vladimir-aubrecht/BelimoCRAB1P/(commit log)

2023-03-04 Added scheme
    [BelimoCRAB1P.kicad_pcb, BelimoCRAB1P.kicad_sch]
2023-03-04 Added working support for reading of current state.
    [configuration.h]
2023-03-11 Added printables link.
2023-03-11 When connection fails during the startup, then access point is started and allows reconfiguration through web interface. After reconfiguration is done, device is automatically restarted.
    [configuration.h, configurationServer.h]
2023-03-11 Fixed bugs
    [configuration.h, configurationServer.h]
2023-09-02 - Web server is running all the time. - Added support for OTA updates of firmware. No need of cable anymore. - Logs are accessible through serial or through web server. - Passwords are rendered into 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
    [configurationServer.h]
2025-06-14 Improved logging and added retry for mqtt connection when mqtt connection drops
    [configurationServer.h]
2025-06-15 Initial hack
    [configurationServer.h]
2025-06-15 Refactored, but not tested yet
    [configuration.h]
2025-06-16 Working support for HA + improved logging
    [configuration.h]
